vkshardware/frictions/README.md

**vksensor ATV GAZ-71 Friction Clutches controller v2.5**

author: vkshardware (vks100@mail.ru)

GAZ-71 gear Friction Clutches release controllers for 4x4 big tires side-turning ATV like SHERP

2-channel controller for ATV with 1 GP (main gearbox GAZ-71)

4-channel controller for ATV with 2 GP (main gearbox GAZ-71)

Used two electric actuators (Bringsmart 1500N 20mm/s 50mm or Sumotor 1000N 30mm/s 50mm).  

Tourning of ATV is controlled with switches on levers or resistive joystick. 

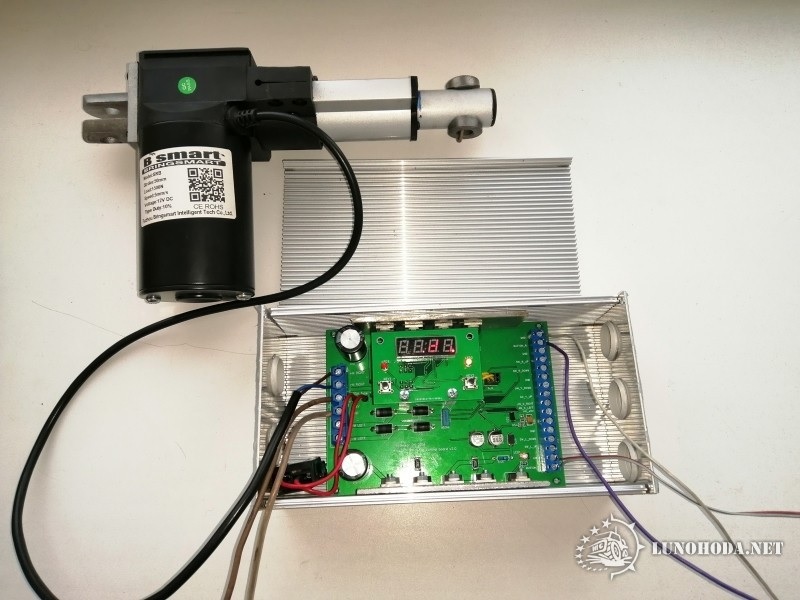
[picture p1: main_view.jpg]


Sources is open and available here

**display** - display board. Atmega8A firmware in Atmel Studio 7

**main_board** - main power board. Atmega324PA firmware in Atmel Strudio 7

****

Electric line actuators mounted like this: 

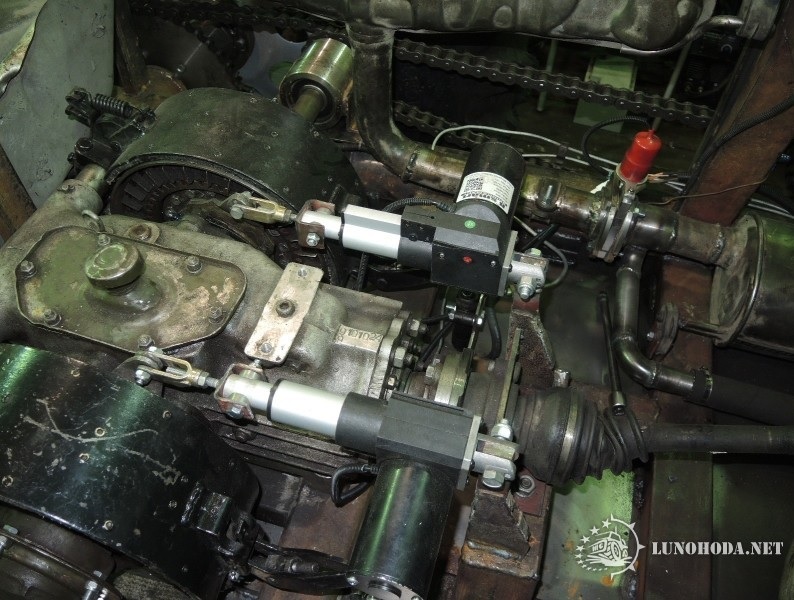
[picture p2: mount_actuators.jpg]


****

Power board module v4.0:

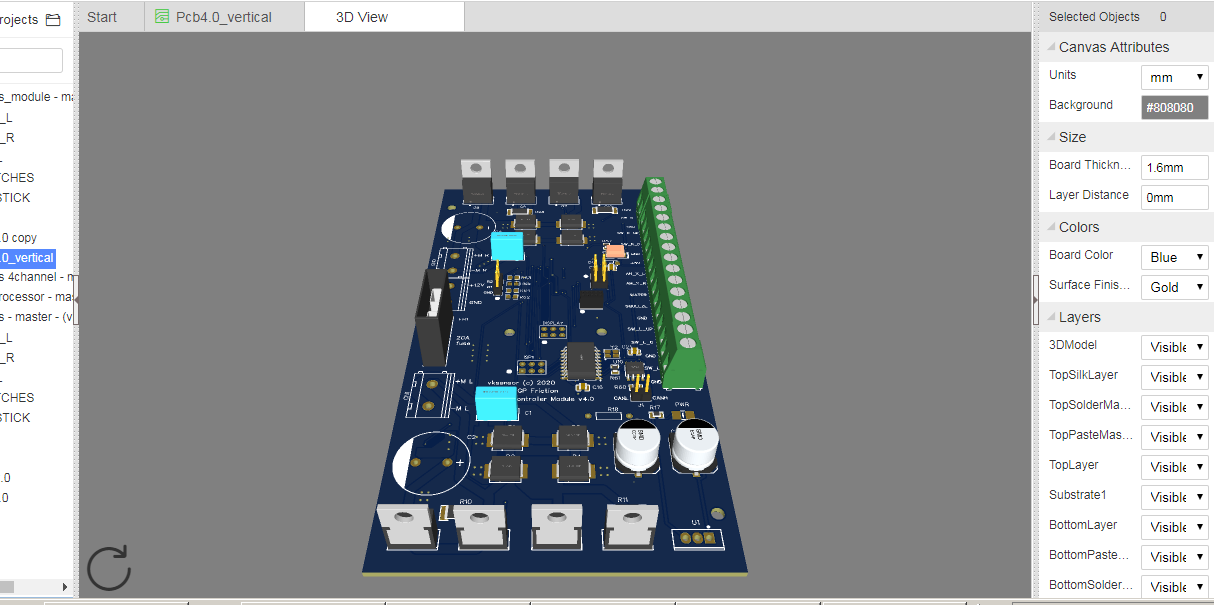
[picture p3: module_v4.0.png]
