vkshardware/frictions/Photos/2-channel controller_pinout_RU.jpg

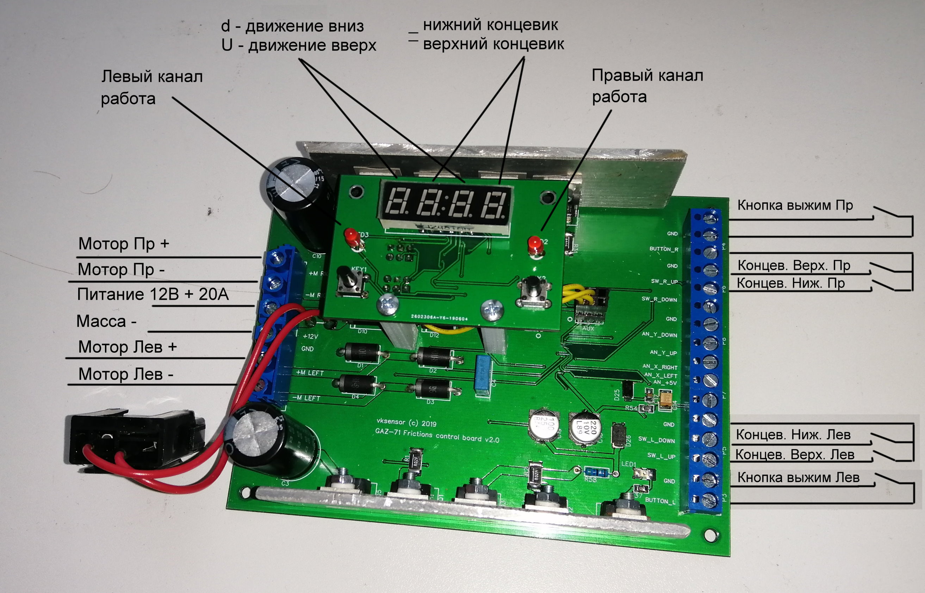
Photos/2-channel controller_pinout_RU.jpg
