vkshardware/frictions/Photos/2-channel controllers 2.jpg

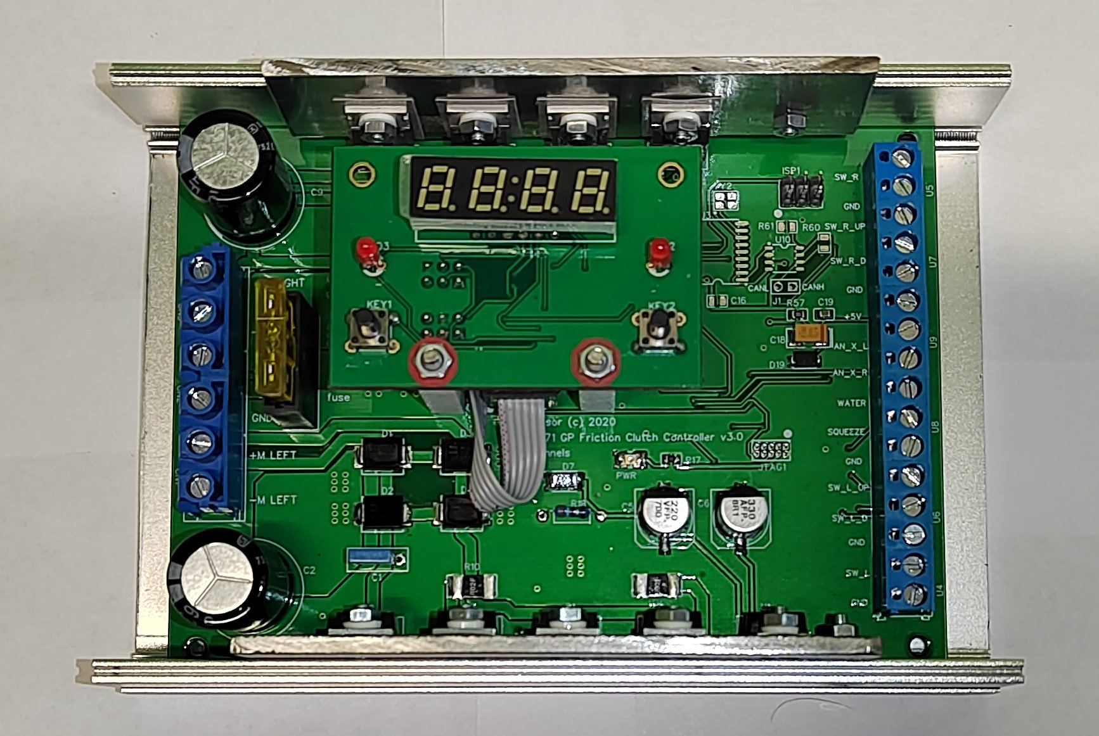
Photos/2-channel controllers 2.jpg
