vkshardware/frictions/Photos/2-channel controllers.jpg

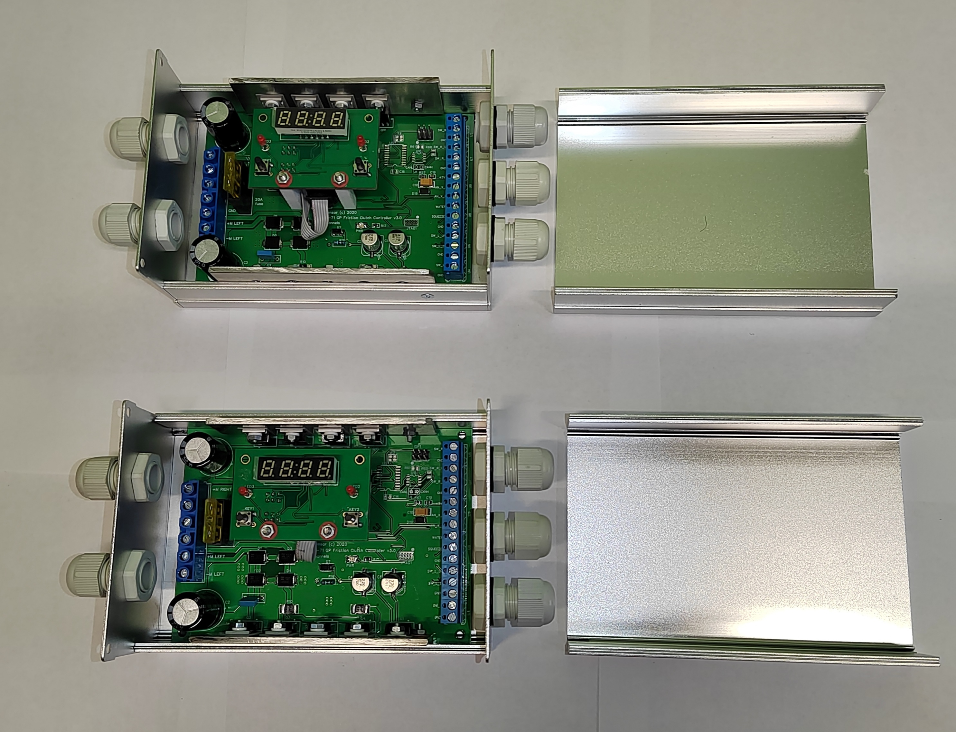
Photos/2-channel controllers.jpg
