vkshardware/frictions/Photos/4-channel controller.jpg

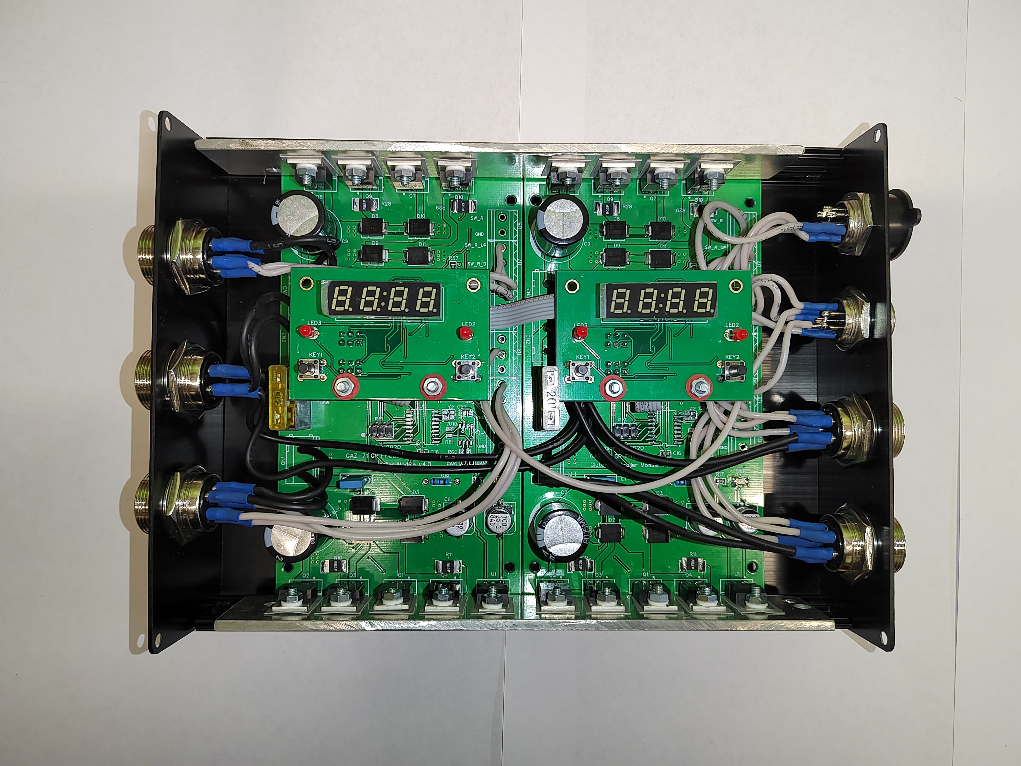
Photos/4-channel controller.jpg
