vkshardware/frictions/Photos/4-channel controller_02.jpg

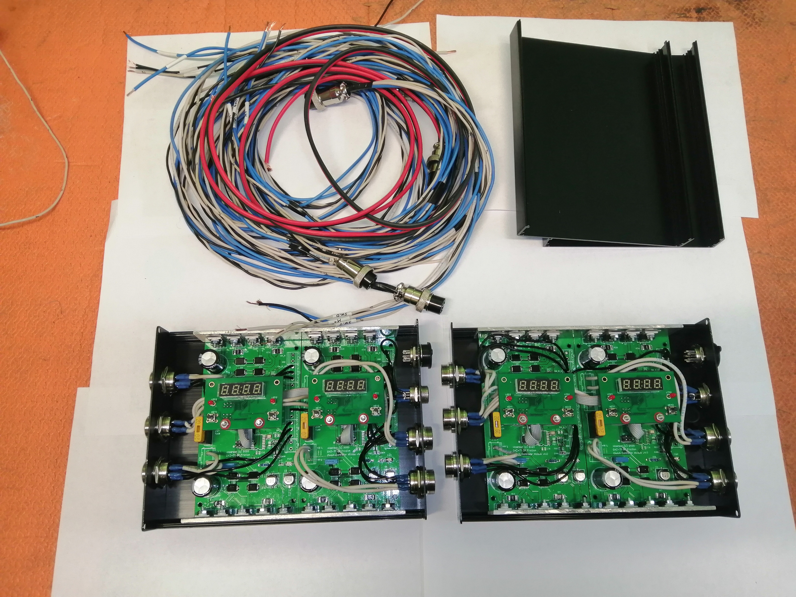
Photos/4-channel controller_02.jpg
