vkshardware/frictions/Photos/4-channel controller_03.jpg

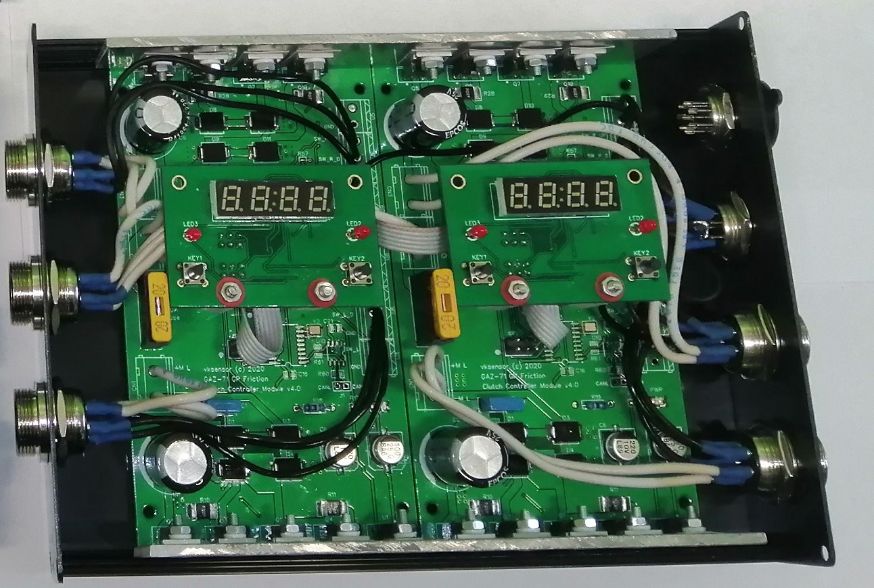
Photos/4-channel controller_03.jpg
