vkshardware/frictions/Photos/4-channel controller_04_RU.png

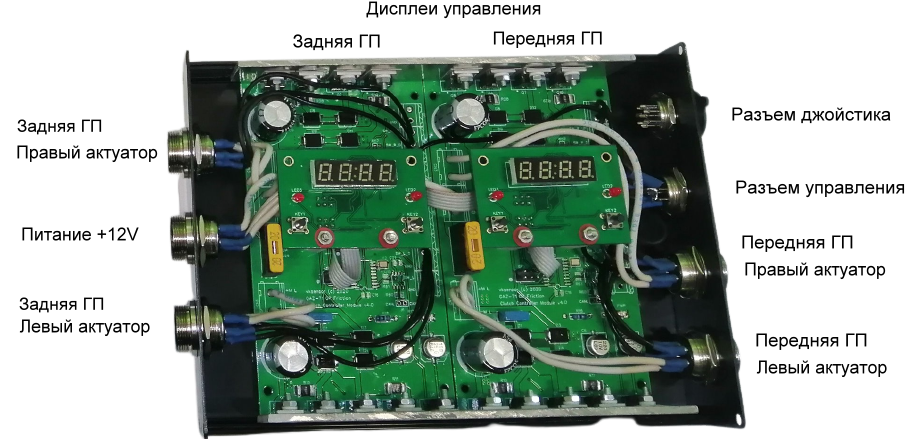
Photos/4-channel controller_04_RU.png
