vkshardware/frictions/Photos/4-channel controller_05.png

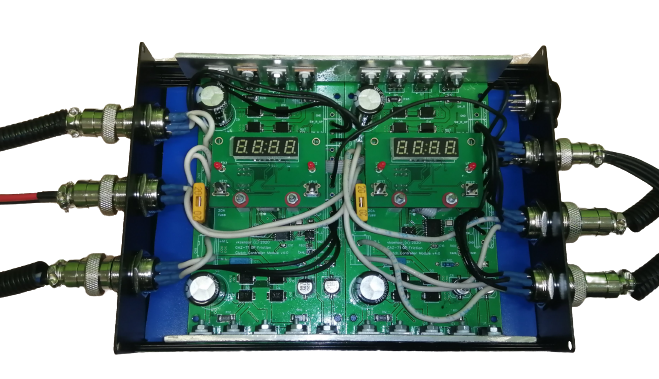
Photos/4-channel controller_05.png
