vkshardware/frictions/Photos/Actuators and Brakes mount/01.JPG

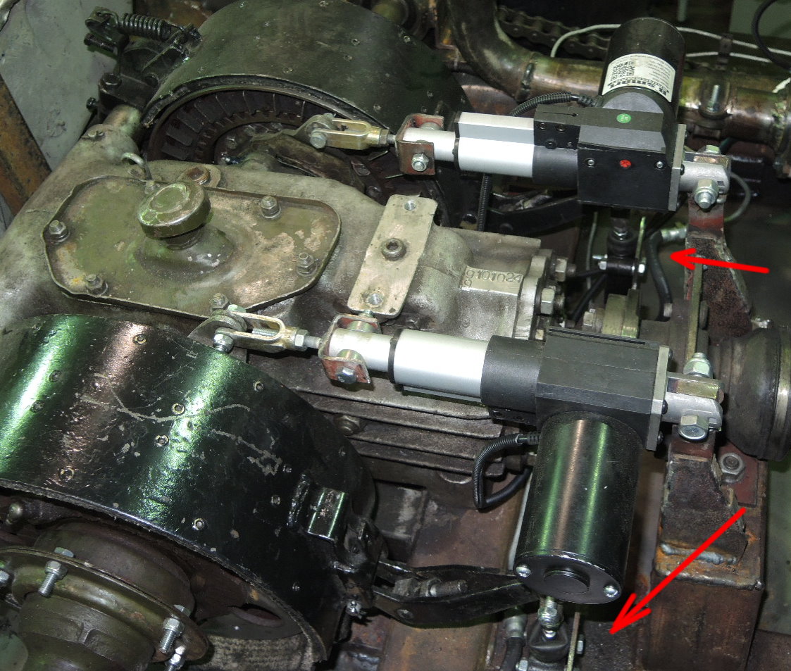
Photos/Actuators and Brakes mount/01.JPG
