vkshardware/frictions/Photos/Actuators and Brakes mount/02.jpg

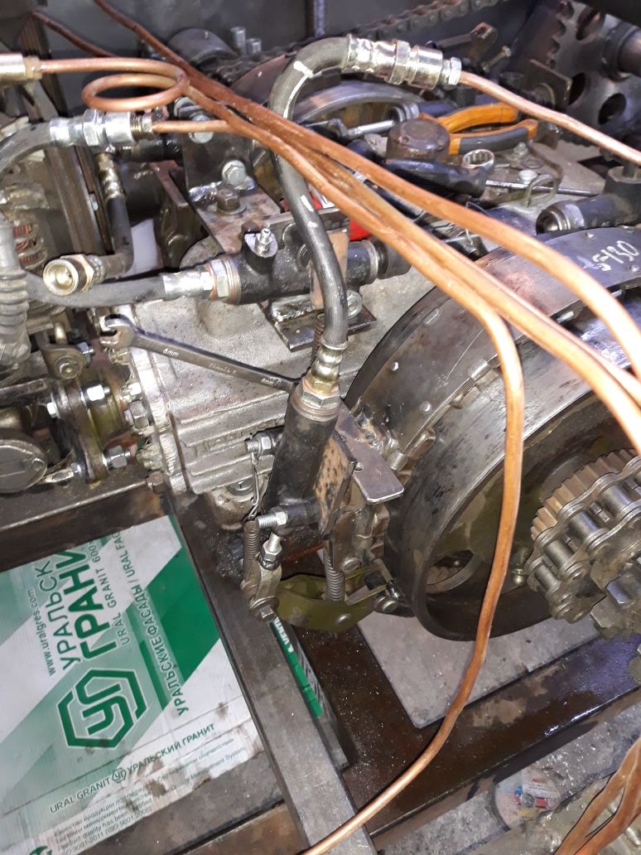
Photos/Actuators and Brakes mount/02.jpg
