vkshardware/frictions/Photos/Actuators and Brakes mount/03.jpg

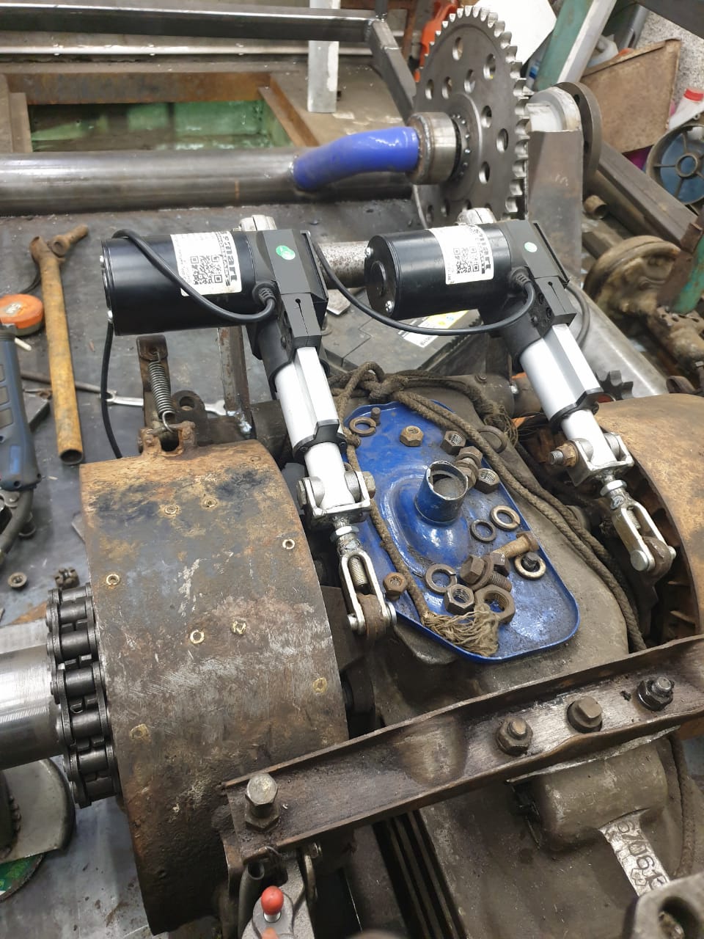
Photos/Actuators and Brakes mount/03.jpg
