vkshardware/frictions/Photos/Actuators and Brakes mount/04.jpg

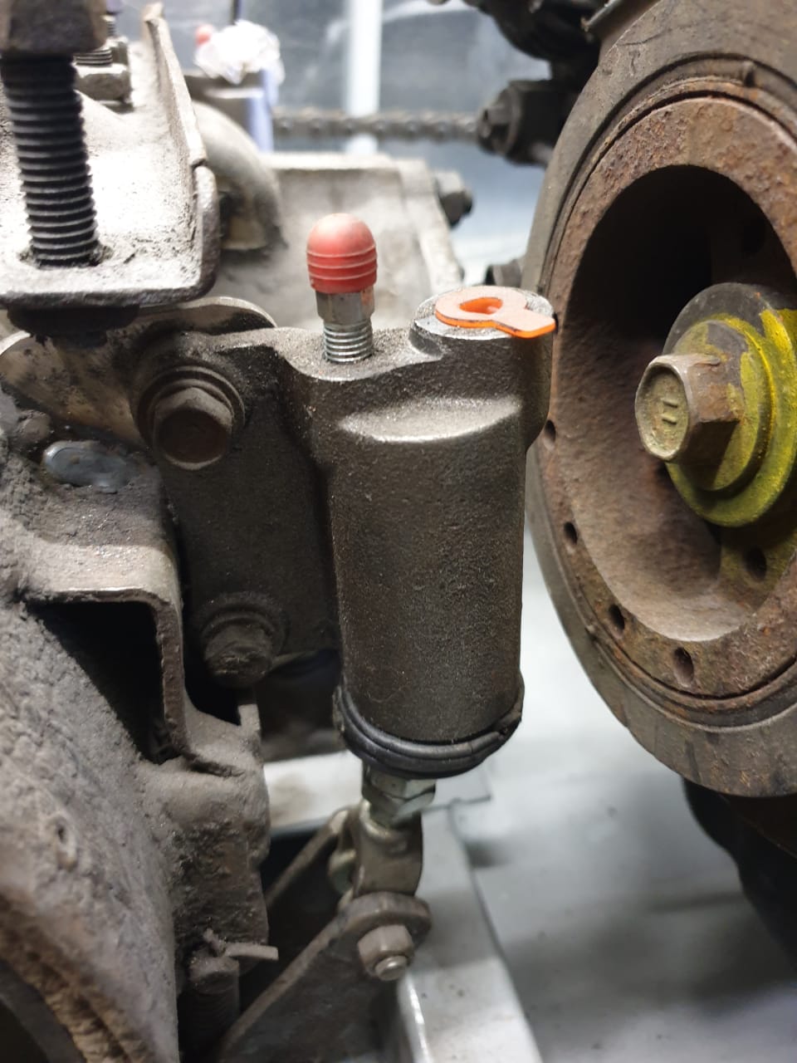
Photos/Actuators and Brakes mount/04.jpg
