vkshardware/frictions/Manuals/actuator _sw1.jpg

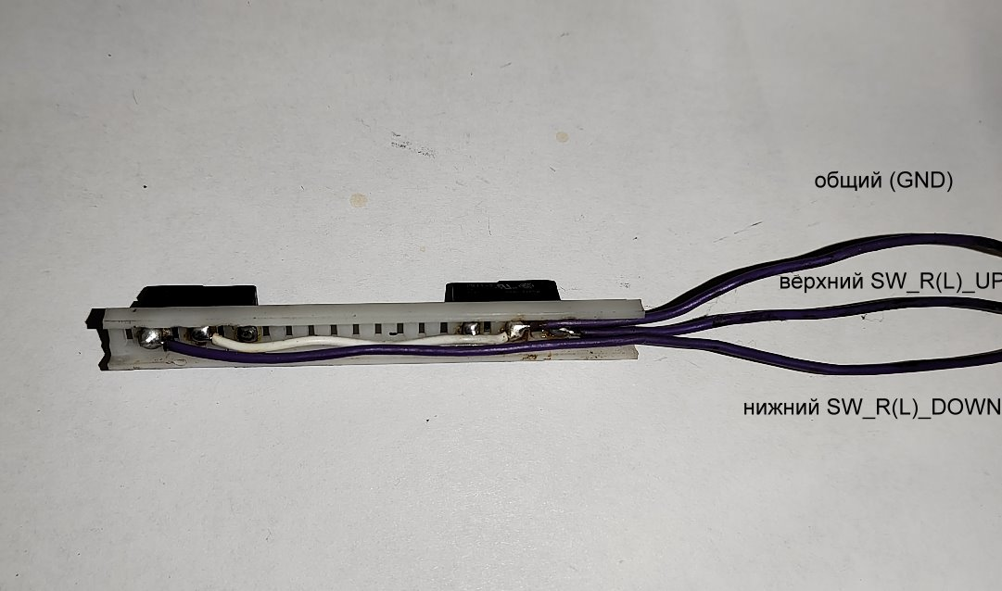
Manuals/actuator _sw1.jpg
