vkshardware/frictions/Manuals/actuator_sw2.jpg

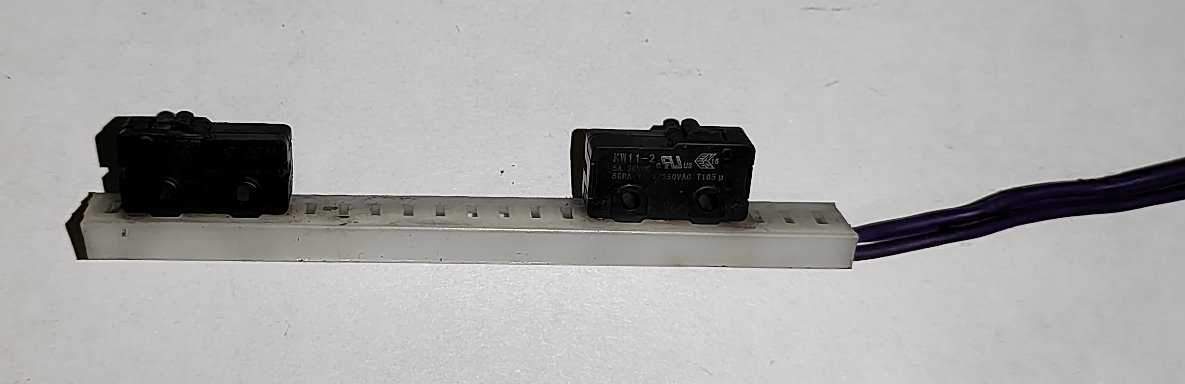
Manuals/actuator_sw2.jpg
