vkshardware/frictions/Photos/2-channell controller installation.jpg

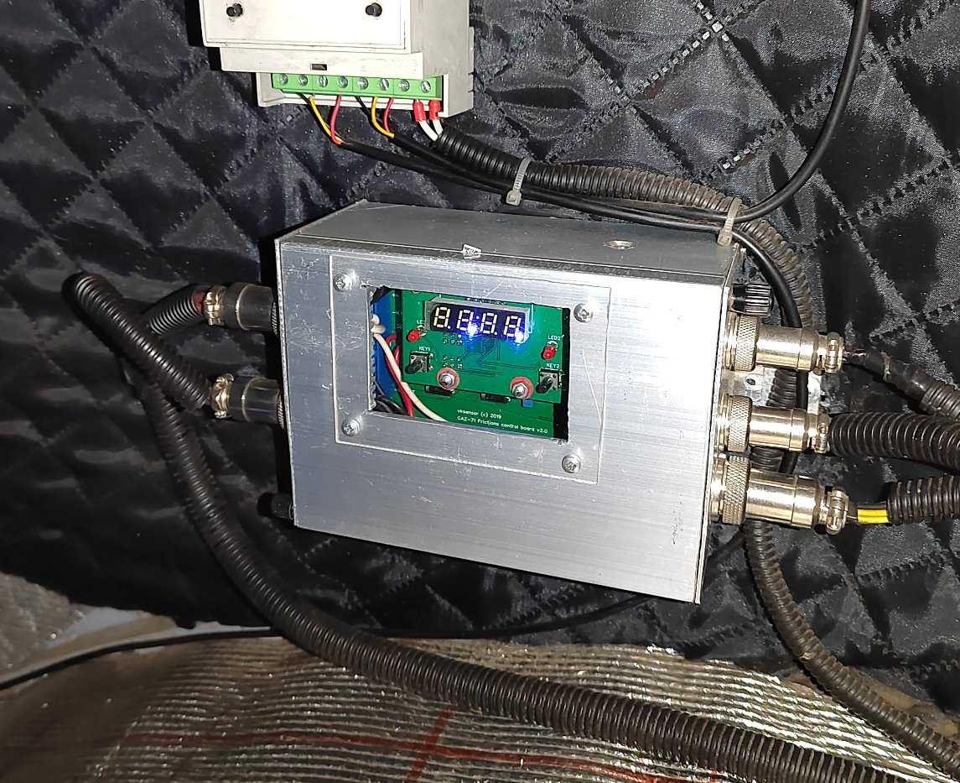
Photos/2-channell controller installation.jpg
