vkshardware/frictions/Schematic/Main_board_atmega324PA/Schematic_friction_module.pdf

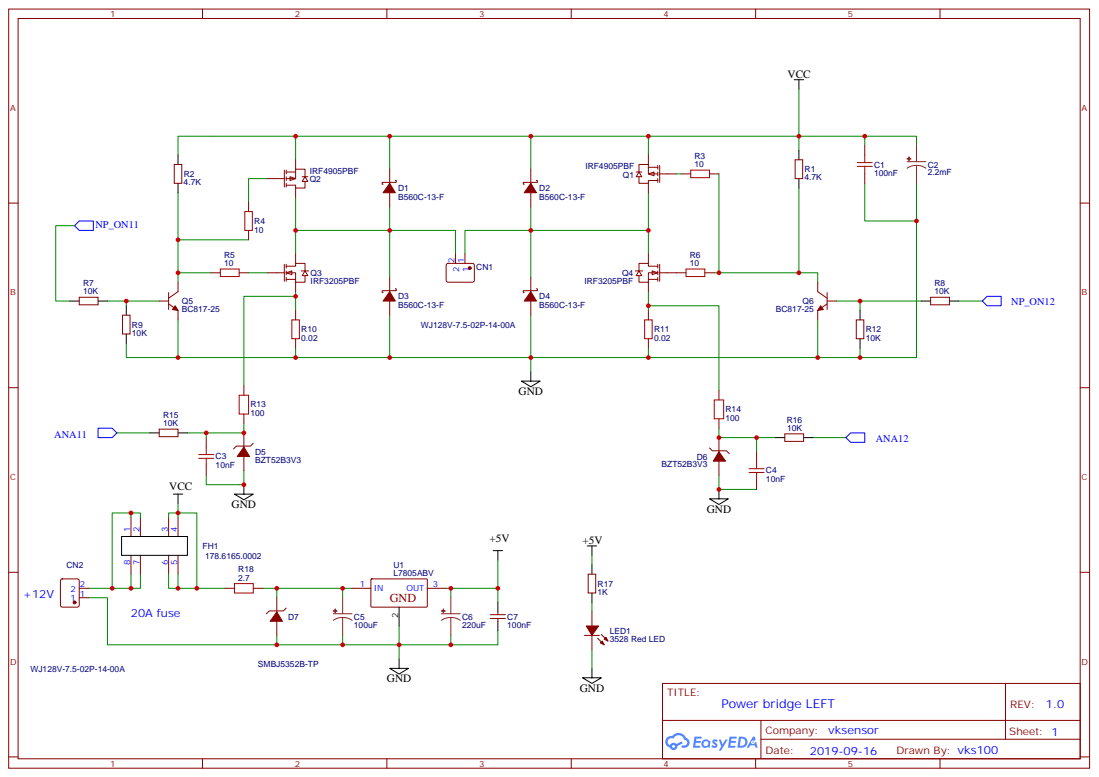
[picture p71: page 1]

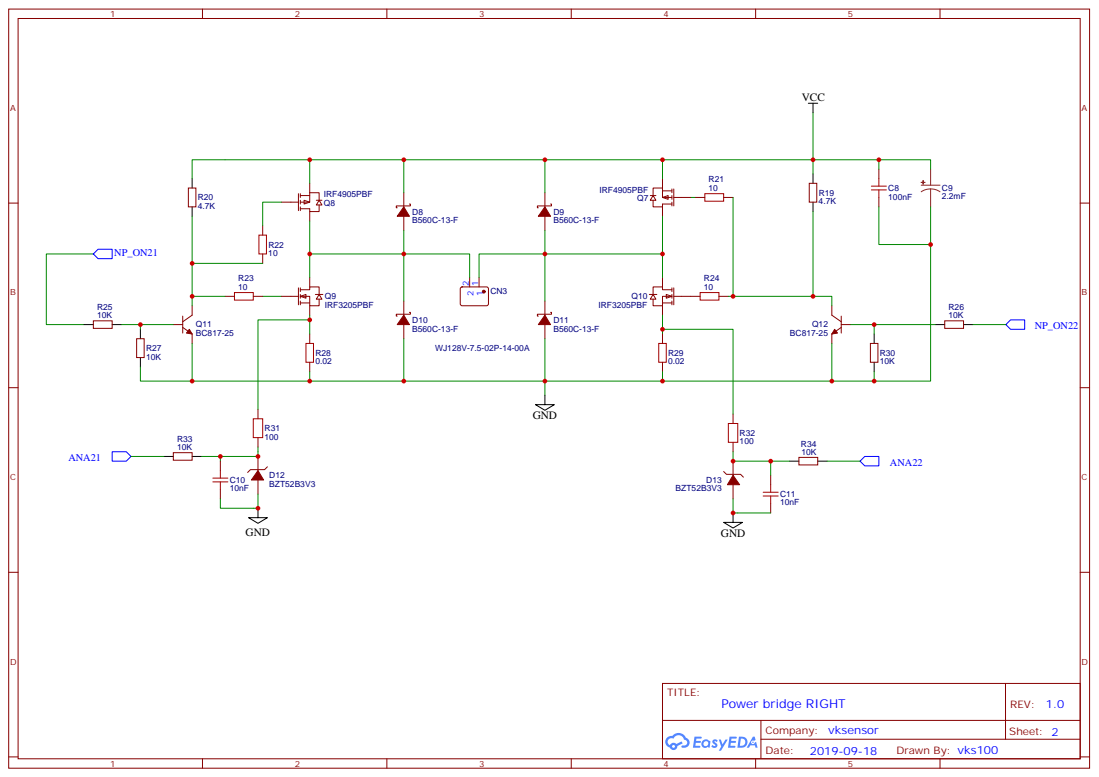
[picture p72: page 2]

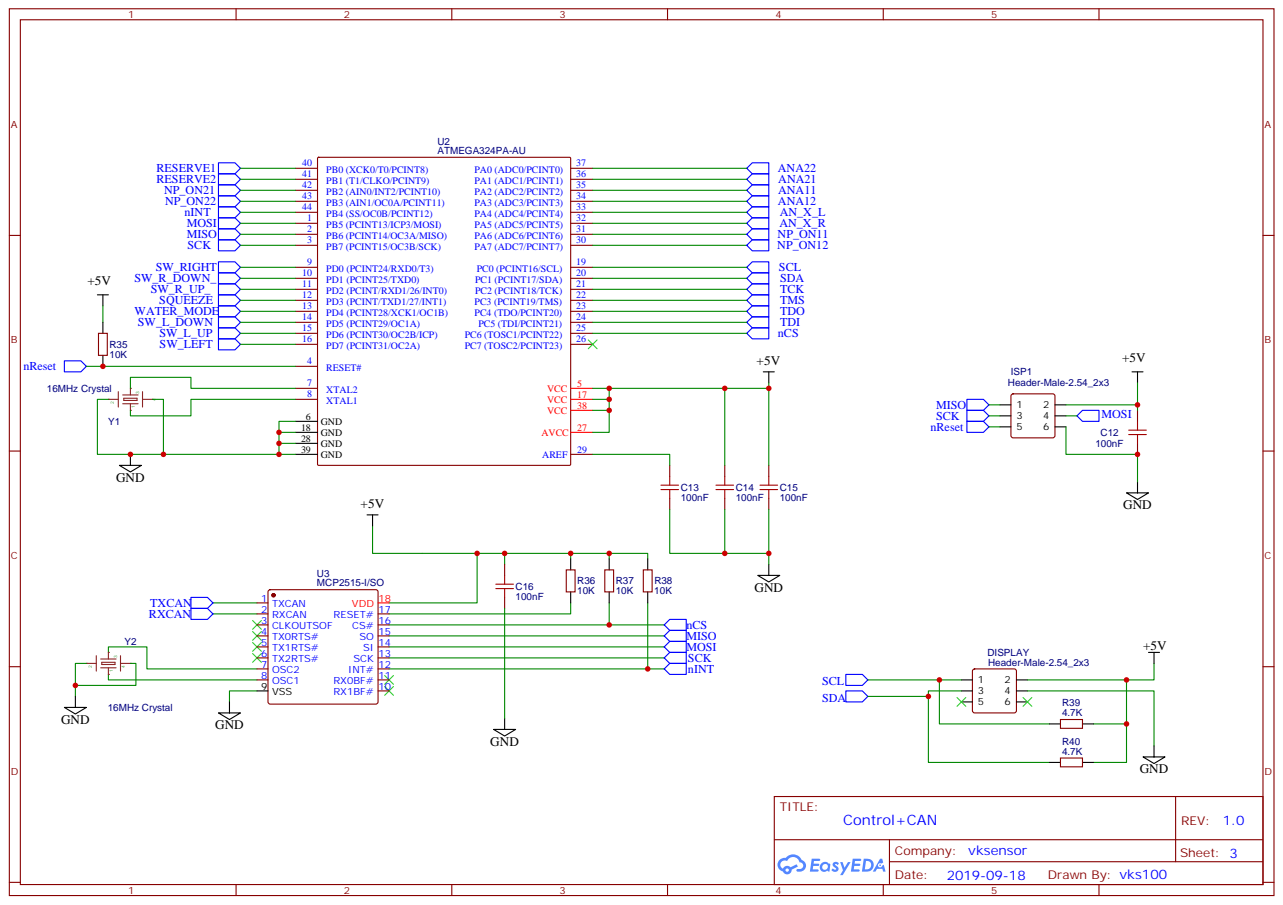
[picture p73: page 3]

MCP2515-I/SO
RX1BF# 10 RX0BF# 11 INT# 12 SCK 13 SI 14 SO 15 CS# 16 RESET# 17 VDD 18

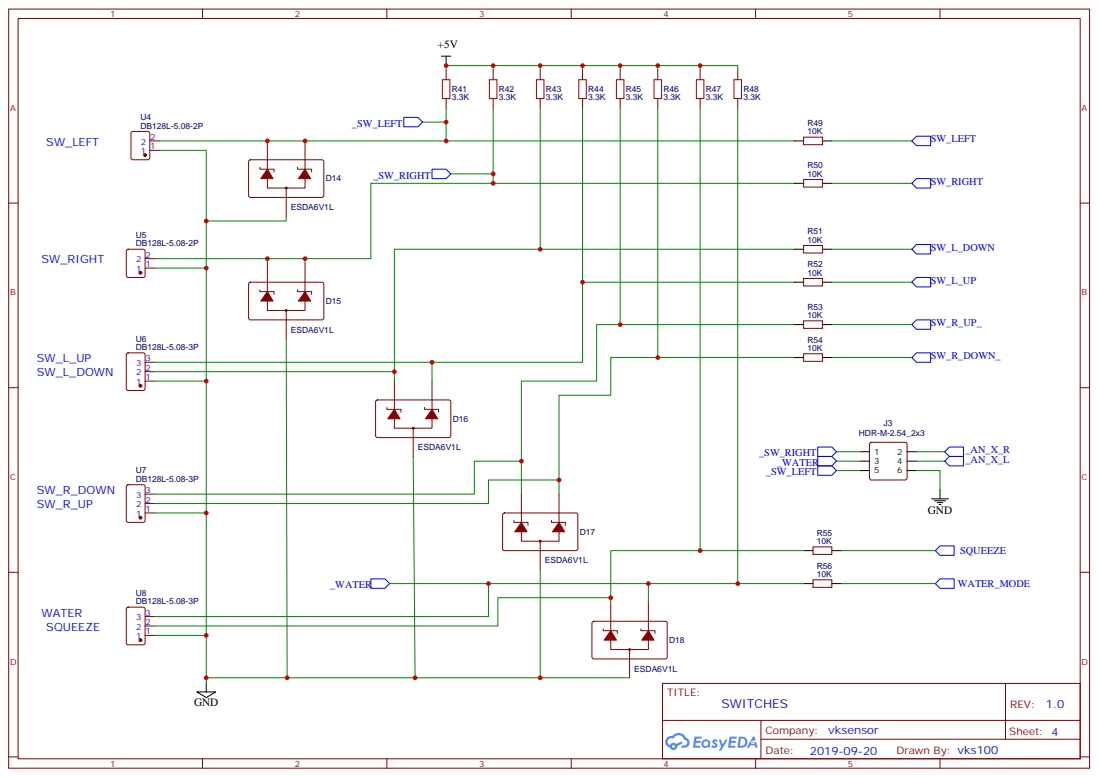
[picture p74: page 4]

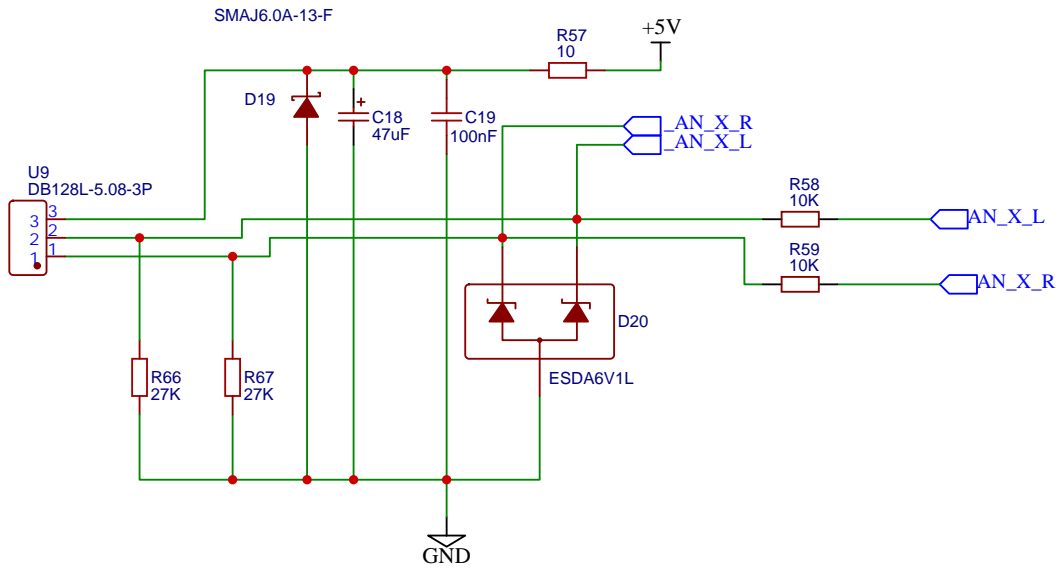
[picture p75: page 5]

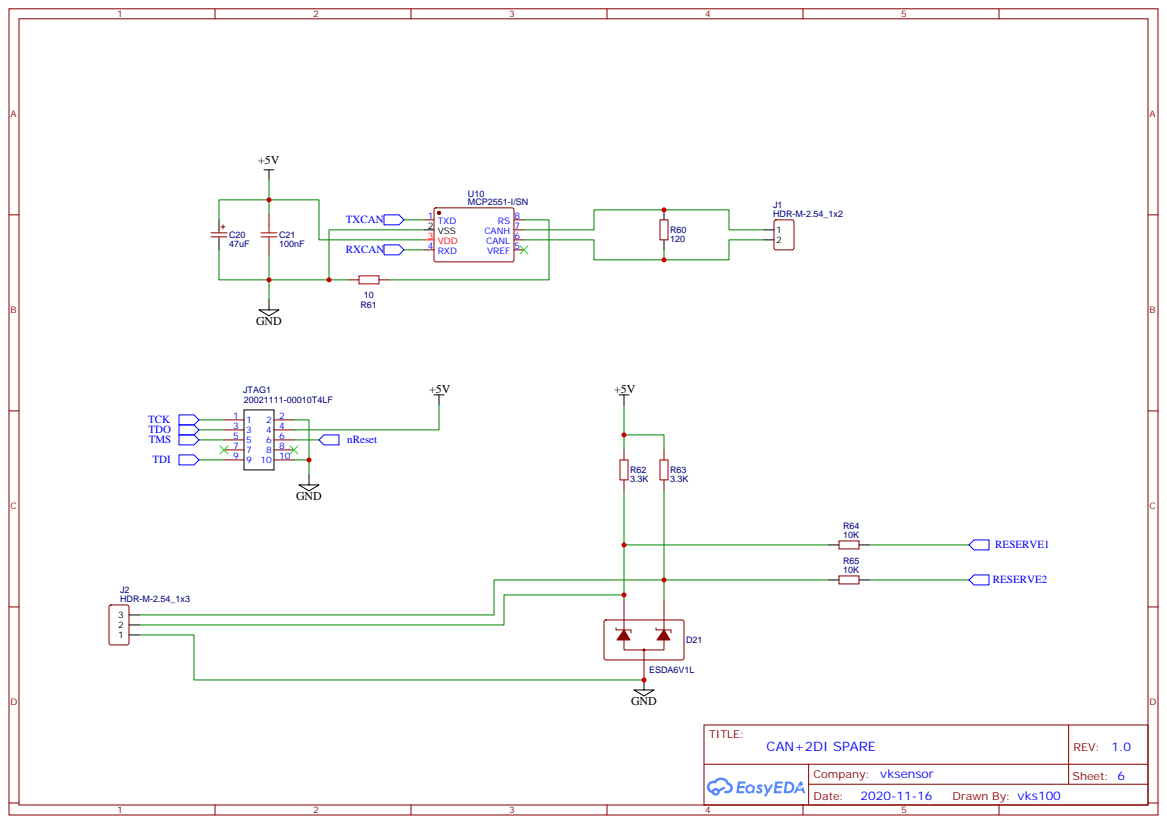
[picture p76: page 6]
