vkshardware/frictions/Schematic/Display_board_atmega324PA/Schematic_disp_seg_i2c.pdf

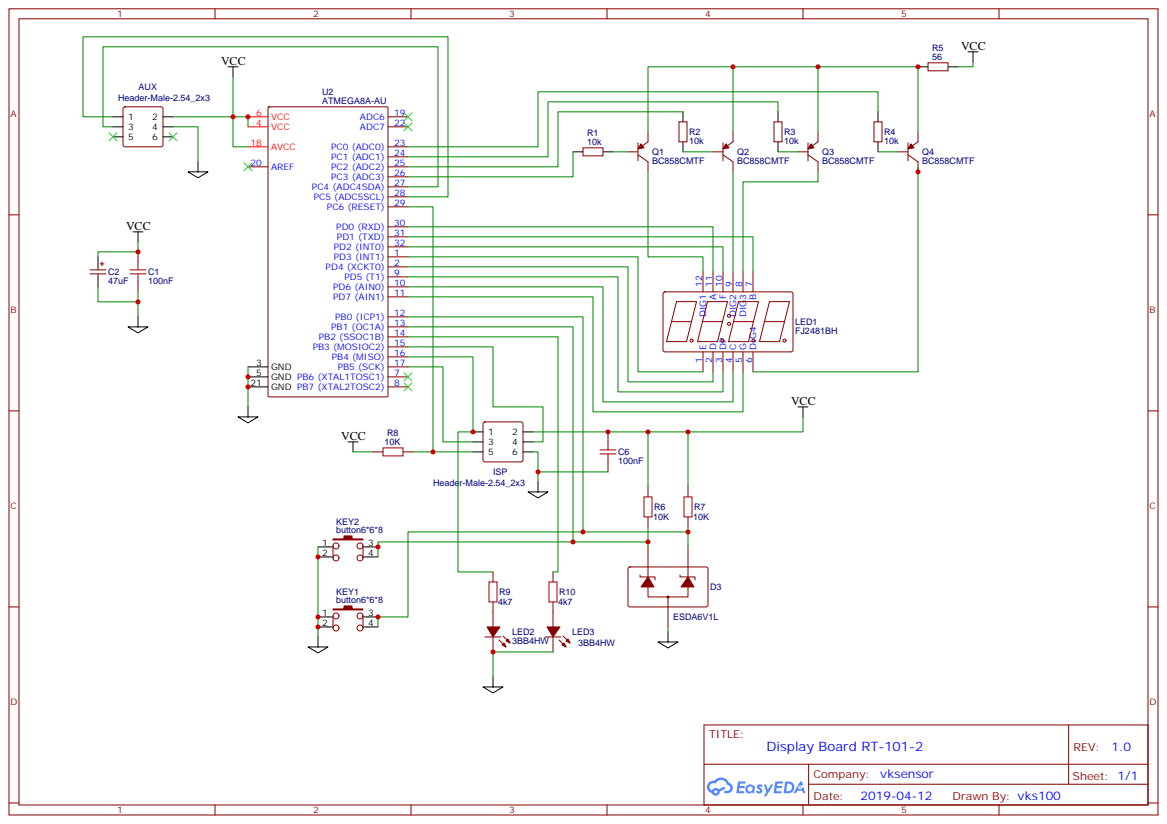
[picture p77: page 1]
