vkshardware/frictions/Schematic/old/Schematic_frictions.pdf

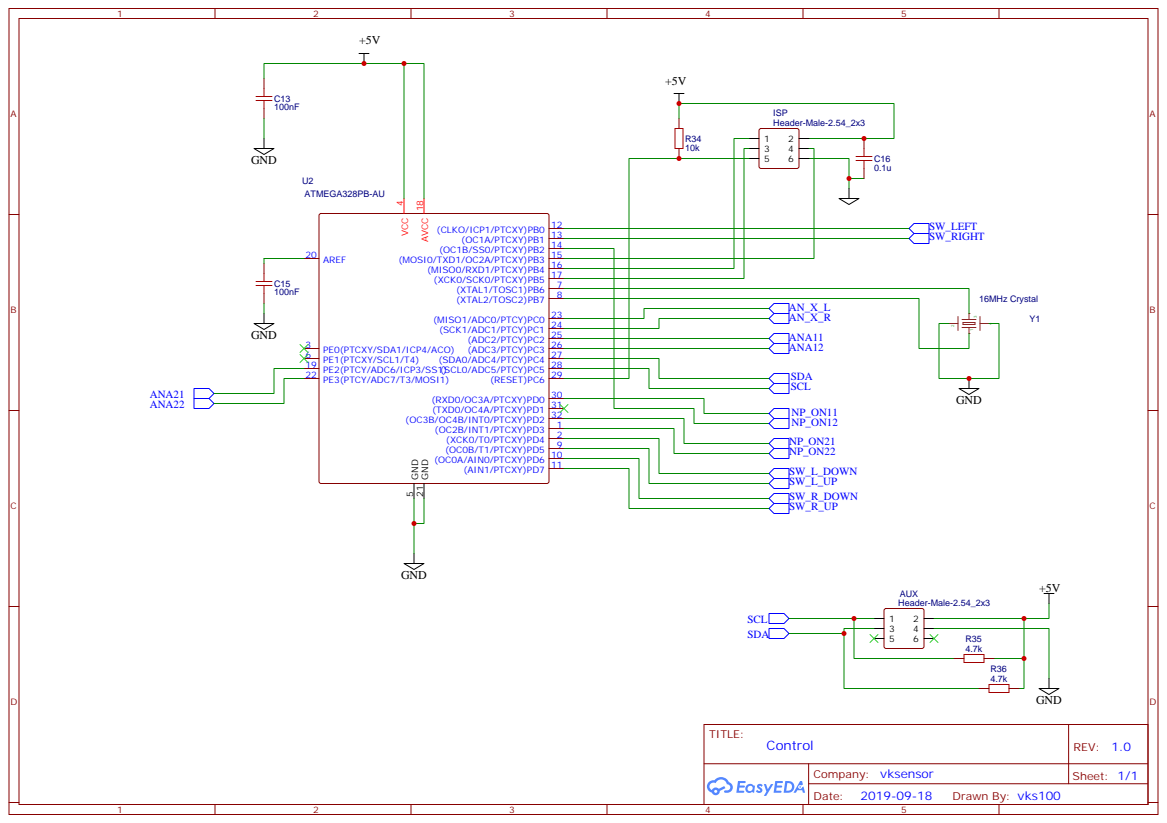
[picture p78: page 1]

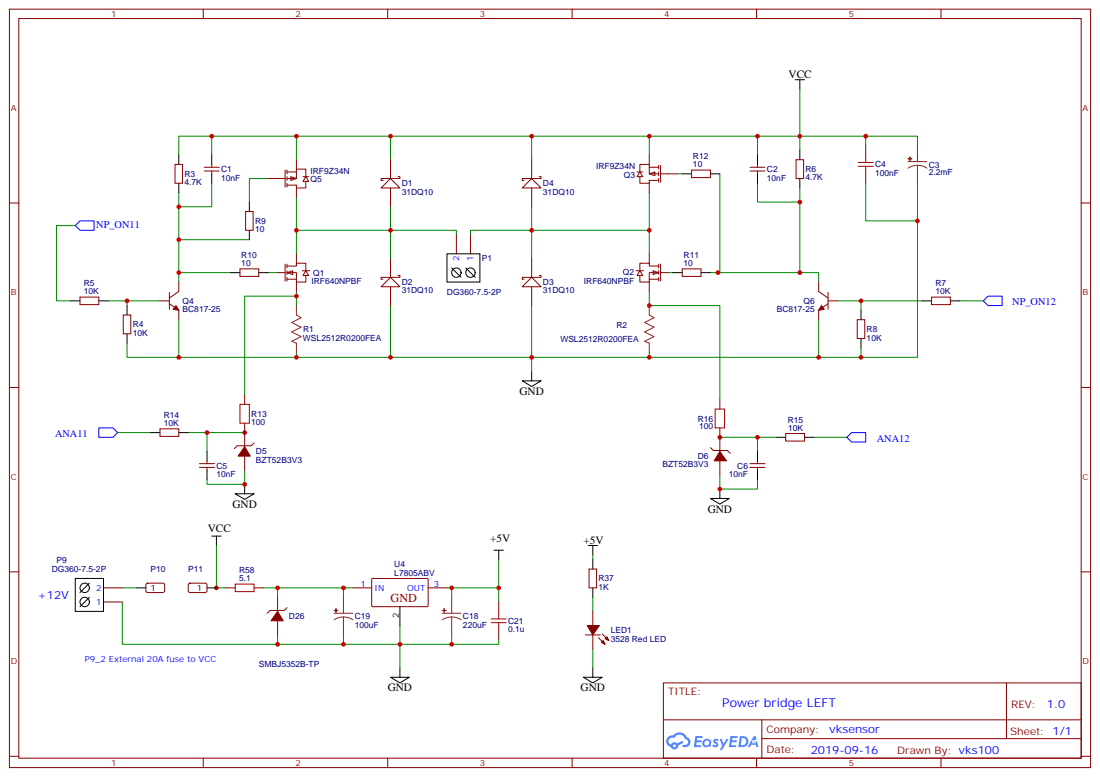
[picture p79: page 2]

P9_2 External 20A fuse to VCC

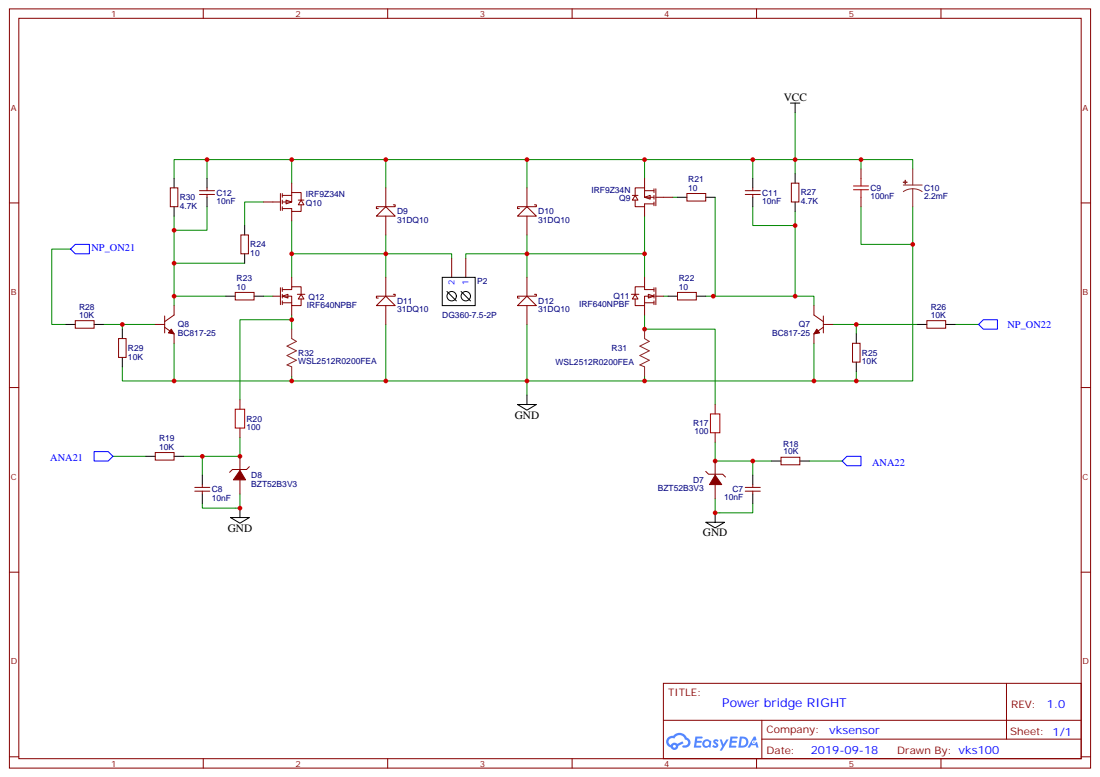
[picture p80: page 3]

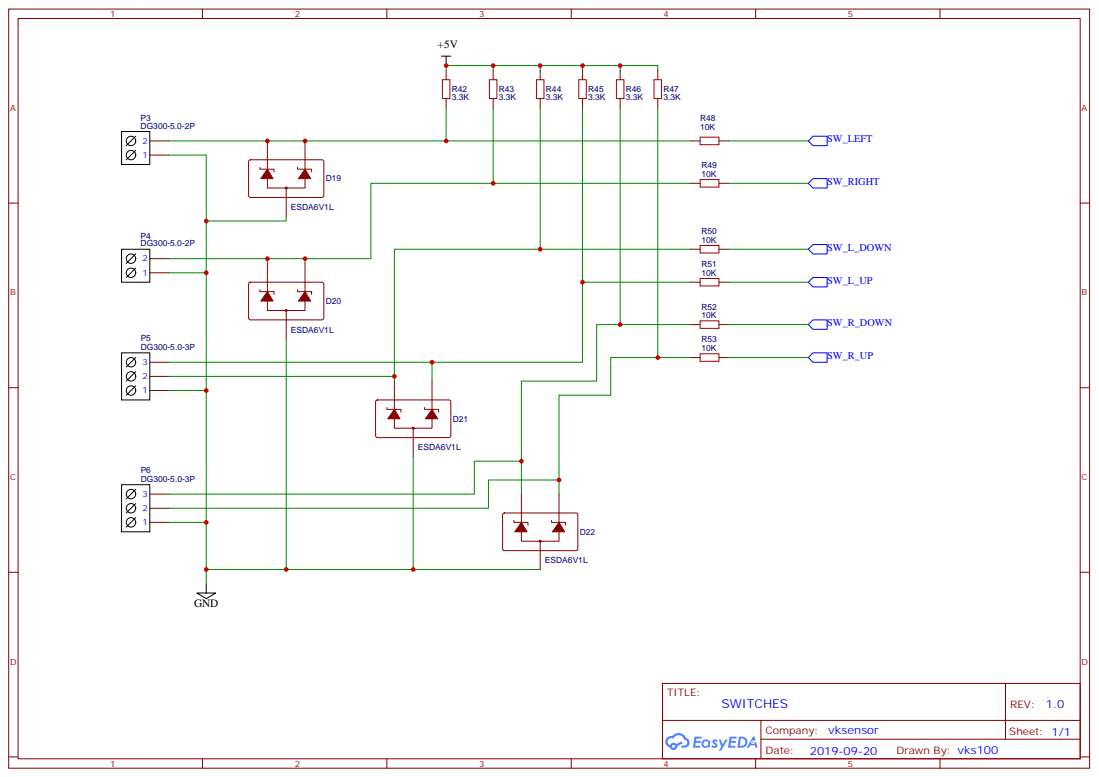
[picture p81: page 4]

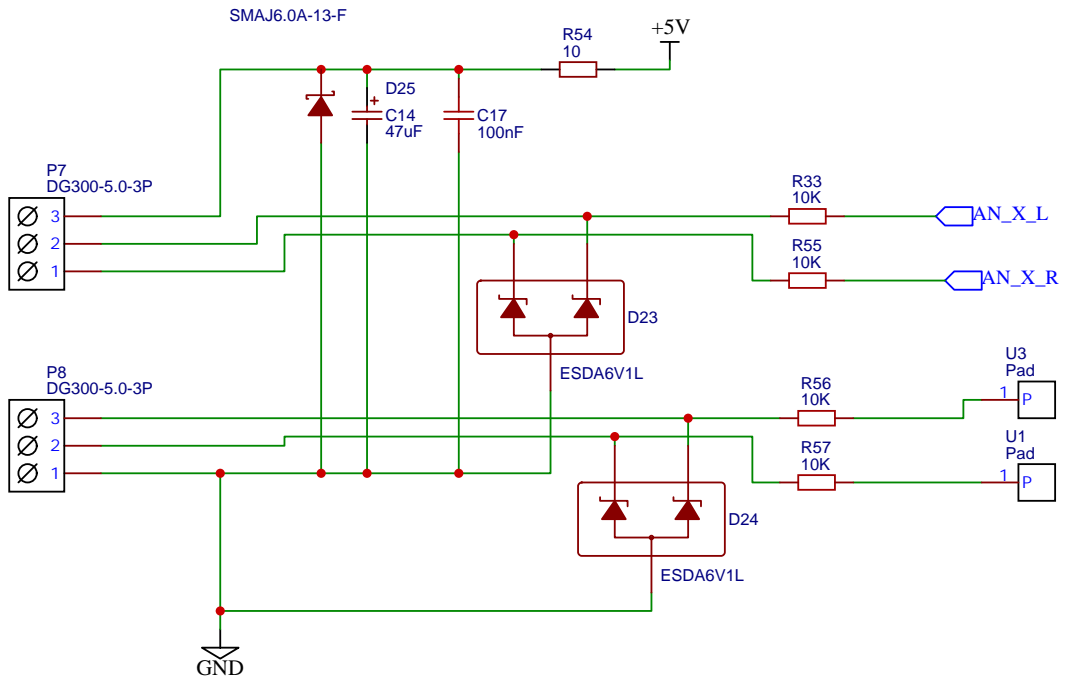
[picture p82: page 5]
