vkshardware/frictions/Firmware/main_board_v2_5/friction_v2.5/spi.cpp

/*************************************************************************

SPI library by Julien Delvaux
*************************************************************************/


#include "spi.h"
/************************************************************************/
/* Constants and macros */
/************************************************************************/
#define SPI_ACTIVE 0 // SS Pin put Low
#define SPI_INACTIVE 1 // SS Pin put High
/* size of RX/TX buffers */
#define SPI_RX_BUFFER_MASK ( SPI_RX_BUFFER_SIZE - 1)
#define SPI_TX_BUFFER_MASK ( SPI_TX_BUFFER_SIZE - 1)
#if ( SPI_RX_BUFFER_SIZE & SPI_RX_BUFFER_MASK )
#error RX buffer size is not a power of 2
#endif
#if ( SPI_TX_BUFFER_SIZE & SPI_TX_BUFFER_MASK )
#error TX buffer size is not a power of 2
#endif
#if defined(__AVR_ATmega48A__) ||defined(__AVR_ATmega48PA__) || defined(__AVR_ATmega88A__) || \
defined(__AVR_ATmega88PA__) ||defined(__AVR_ATmega168A__) || defined(__AVR_ATmega168PA__) || \
defined(__AVR_ATmega328P__)
#define SPI_PIN_SS 2 //SS PIN
#define SPI_PIN_MOSI 3 //MOSI PIN
#define SPI_PIN_MISO 4 //MISO PIN
#define SPI_PIN_SCK 5 //SCK PIN
#define SPI_DDR DDRB //SPI on PORTB
#define SPI_PORT PORTB //SPI on PORTB
#elif defined(__AVR_ATmega164P__) || defined(__AVR_ATmega324PA__) || defined(__AVR_ATmega644P__) || \
defined(__AVR_ATmega1284P__)
#define SPI_PIN_SS 4 //SS PIN
#define SPI_PIN_MOSI 5 //MOSI PIN
#define SPI_PIN_MISO 6 //MISO PIN
#define SPI_PIN_SCK 7 //SCK PIN
#define SPI_DDR DDRB //SPI on PORTB
#define SPI_PORT PORTB //SPI on PORTB
#else
#error "no SPI definition for MCU available"
#endif
/************************************************************************/
/* Global variable */
/************************************************************************/
static volatile uint8_t SPI_TxBuf[SPI_TX_BUFFER_SIZE];
static volatile uint8_t SPI_RxBuf[SPI_RX_BUFFER_SIZE];
static volatile uint8_t SPI_TxHead;
static volatile uint8_t SPI_TxTail;
static volatile uint8_t SPI_RxHead;
static volatile uint8_t SPI_RxTail;
#if defined (SPI_MASTER_ENABLED) && defined(SPI_SLAVE_ENABLED)
#error The multimaster mode of SPI is not yet implement. Do not hesitate to implement it, then submit a pull request ! Thx
#elif defined(SPI_MASTER_ENABLED)
static volatile uint8_t SPI_CTS;
static volatile uint8_t SPI_bytesRequest; // Number of bytes request
#elif defined(SPI_SLAVE_ENABLED)
static volatile uint8_t SPI_SPDR;
#define SPI_SPDR_EMPTY 0
#define SPI_SPDR_FULL 1
#endif

ISR(SPI_STC_vect)
/*************************************************************************
Function: SPI interrupt
Purpose: called when the SS pin has been put low
**************************************************************************/
{
	uint16_t tmphead=0;
	uint16_t tmptail=0;

	/* SPI MASTER */
	#if defined (SPI_MASTER_ENABLED)

	//RECEIVE
	// calculate buffer index
	tmphead = ( SPI_RxHead + 1) & SPI_RX_BUFFER_MASK;
	if ( tmphead == SPI_RxTail ) {
		// error: receive buffer overflow

		} else {
		// store new index
		SPI_RxHead = tmphead;
		// store received data in buffer
		SPI_RxBuf[tmphead] = SPDR0;
	}
	// SEND
	if ( SPI_TxHead != SPI_TxTail) {
		// calculate and store new buffer index
		tmptail = (SPI_TxTail + 1) & SPI_TX_BUFFER_MASK;
		SPI_TxTail = tmptail;
		// get one byte from buffer and write it to UART
		SPDR0 = SPI_TxBuf[tmptail]; // start transmission
	}
	else if(SPI_bytesRequest>0){
		SPI_bytesRequest--;
		SPDR0 = 0x00;
	}
	else {
		// tx buffer empty, STOP the transmission
		SPI_PORT|= (1<<SPI_PIN_SS);
		SPI_CTS = SPI_INACTIVE;
	}
	/* SPI Slave */
	#elif defined(SPI_SLAVE_ENABLED)

	//RECEIVE
	// calculate buffer index
	tmphead = ( SPI_RxHead + 1) & SPI_RX_BUFFER_MASK;
	if ( tmphead == SPI_RxTail ) {
		// error: receive buffer overflow

		} else {
		// store new index
		SPI_RxHead = tmphead;
		// store received data in buffer
		SPI_RxBuf[tmphead] = SPDR;
	}
	// SEND
	if ( SPI_TxHead != SPI_TxTail) {
		// calculate and store new buffer index
		tmptail = (SPI_TxTail + 1) & SPI_TX_BUFFER_MASK;
		SPI_TxTail = tmptail;
		// get one byte from buffer and write it to UART
		SPDR = SPI_TxBuf[tmptail]; //start transmission
	}
	else{
		SPDR=0x00;
	}

	#endif
}
#if defined (SPI_MASTER_ENABLED)
/*************************************************************************
Function: spi_master_init()
Purpose: Initialize SPI in Master Mode
Input: mode SPI_MODEx (x : 0 -> 3)
Input: clock SPI_CLOCK_DIVx (x : 2, 4, 8, 16, 32, 64 or 128)
Returns: none
**************************************************************************/
void spi_master_init(uint8_t mode, uint8_t clock){

	// Pin Configuration
	SPI_DDR = (1<<SPI_PIN_SS) | (1<<SPI_PIN_MOSI) | (1<<SPI_PIN_SCK); // ss, mosi, sck as output, miso as input
	SPI_PORT|= (1<<SPI_PIN_SS);
	//PORTB = 0xff & ~((1<<SPI_PIN_MISO)); // close miso pull up
	// Enable SPI, Master, set clock rate
	SPCR0 = (1<<SPE0)|(1<<MSTR0)|(mode<<CPHA0)|(clock<<SPR00);
}
/*************************************************************************
Function: spi_master_transmit()
Purpose: transmit string to SPI and launch the SPI communication
Input: string to be transmitted
Returns: none
**************************************************************************/
void spi_master_transmit(const char cData){

	/* Start transmission */
	SPDR0 = cData;
	/* Wait for transmission complete */
	// if SPIF == 0
	while(!(SPSR0 & (1<<SPIF0)))
	;

}
/*************************************************************************
Function: spi_master_read()
Purpose: transmit 0x00 to get the number of bytes requested
Input: numberOfBytes that want to be read
Returns: none
**************************************************************************/
char spi_read(void)
{
	SPDR0 = 0x00;
	/* Wait for reception complete */
	while(!(SPSR0 & (1<<SPIF0)))
	;
	/* Return Data Register */
	return SPDR0;
}
/*void spi_master_addSlave(spi_slave_info slave){

}
void spi_master_transmitToSlave(spi_slave_info slave, const char *s){

}*/
#elif defined (SPI_SLAVE_ENABLED)
/*************************************************************************
Function: spi_slave_init()
Purpose: Initialize SPI in Slave Mode
Input: none
Returns: none
**************************************************************************/
void spi_slave_init(void){
	// Set MISO output, all others input
	SPI_DDR |= (1<<SPI_PIN_MISO);
	// set SPI enable, spi interrupts disable
	SPCR = (1<<SPE);
}
/*************************************************************************
Function: spi_slave_receive()
Purpose: read SPI in Slave Mode
Input: none
Returns: none
**************************************************************************/
char spi_slave_receive(void)
{
	SPDR = 0x00;
	/* Wait for reception complete */
	while(!(SPSR & (1<<SPIF)))
	;
	/* Return Data Register */
	return SPDR;
}

#endif
/*************************************************************************
Function: spi_close()
Purpose: Close SPI, flush and clear any received datas
Input: none
Returns: none
**************************************************************************/
void spi_close(void){

	spi_flush();

	SPCR0 = (0x00);
	SPI_DDR &= ~(1<<SPI_PIN_SS);
	SPI_PORT&= ~(1<<SPI_PIN_SS);

}
/*************************************************************************
Function: spi_getc()
Purpose: return byte from ringbuffer
Returns: byte: received byte from ringbuffer
**************************************************************************/
uint8_t spi_getc(void)
{
	uint16_t tmptail;
	uint8_t data;
	if ( SPI_RxHead == SPI_RxTail ) {
		/* no data available */
	}
	/* calculate /store buffer index */
	tmptail = (SPI_RxTail + 1) & SPI_RX_BUFFER_MASK;
	SPI_RxTail = tmptail;
	/* get data from receive buffer */
	data = SPI_RxBuf[tmptail];
	return data;
}
/*************************************************************************
Function: spi_putc()
Purpose: write byte to ringbuffer for transmitting via SPI
Input: byte to be transmitted
Returns: none
**************************************************************************/
void spi_putc(uint8_t data)
{
	uint16_t tmphead;
	tmphead = (SPI_TxHead + 1) & SPI_TX_BUFFER_MASK;

	#if defined (SPI_SLAVE_ENABLED)
	// If no char in SPDR -> fill directly
	if (SPI_TxHead == SPI_TxTail && SPI_SPDR==SPI_SPDR_EMPTY){
		SPDR = data;
		SPI_SPDR = SPI_SPDR_FULL;
	}
	else if (tmphead != SPI_TxTail){
		SPI_TxBuf[tmphead] = data;
		SPI_TxHead = tmphead;
	}
	#elif defined (SPI_MASTER_ENABLED)
	if (tmphead != SPI_TxTail){
		SPI_TxBuf[tmphead] = data;
		SPI_TxHead = tmphead;
	}
	#endif

}
/*************************************************************************
Function: spi_puts()
Purpose: transmit string to SPI
Input: string to be transmitted
Returns: none
**************************************************************************/
void spi_puts(const char *s )
{
	while (*s) {
		spi_putc(*s++);
	}
}
/*************************************************************************
Function: spi_available()
Purpose: Determine the number of bytes waiting in the receive buffer
Input: None
Returns: Integer number of bytes in the receive buffer
**************************************************************************/
uint16_t spi_available(void)
{
	return (SPI_RX_BUFFER_SIZE + SPI_RxHead - SPI_RxTail) & SPI_RX_BUFFER_MASK;
}
/*************************************************************************
Function: spi_flush()
Purpose: Flush bytes waiting the receive buffer. Acutally ignores them.
Input: None
Returns: None
**************************************************************************/
void spi_flush(void)
{
	SPI_RxHead = SPI_RxTail;
}
