vkshardware/frictions/Firmware/main_board_v2_5/friction_v2.5/spi.h

 
/************************************************************************
Title: Interrupt SPI library with receive/transmit circular buffers
Author: Julien Delvaux
Software: Atmel Studio 7
Hardware: AVR 8-Bits, tested with ATmega1284P and ATmega88PA-PU
License: GNU General Public License 3
Usage: see Doxygen manual
 
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
************************************************************************/
/**
* @defgroup avr-spi SPI Library
* @code #include <SPI.h> @endcode
*
* @brief Interrupt SPI library using the built-in SPI with transmit and receive circular buffers.
*
* This library can be used to transmit and receive data through the built in SPI.
*
* @author Julien Delvaux < delvaux.ju@gmail.com>
*/

#ifndef SPI_H_
#define SPI_H_
#include <stdint.h>
#include <avr/io.h>
#include <avr/interrupt.h>
#include <avr/pgmspace.h>

#if (__GNUC__ * 100 + __GNUC_MINOR__) < 304
#error "This library requires AVR-GCC 3.4 or later, update to newer AVR-GCC compiler !"
#endif
/************************************************************************/
/* Constants and macros */
/************************************************************************/
//#define __AVR_ATmega324PA__
/* SPI Mode */
#define SPI_MASTER_ENABLED
//#define SPI_SLAVE_ENABLED
/* Set size of receive and transmit buffers */
#ifndef SPI_RX_BUFFER_SIZE
#define SPI_RX_BUFFER_SIZE 64 /**< Size of the circular receive buffer, must be power of 2 */
#endif
#ifndef SPI_TX_BUFFER_SIZE
#define SPI_TX_BUFFER_SIZE 64 /**< Size of the circular transmit buffer, must be power of 2 */
#endif
/* SPI Mode */
#define SPI_MODE0 0x00
#define SPI_MODE1 0x04
#define SPI_MODE2 0x08
#define SPI_MODE3 0x0C
/* SPI Clock */
#define SPI_CLOCK_DIV4 0x00
#define SPI_CLOCK_DIV16 0x01
#define SPI_CLOCK_DIV64 0x02
#define SPI_CLOCK_DIV128 0x03
#define SPI_CLOCK_DIV2 0x04
#define SPI_CLOCK_DIV8 0x05
#define SPI_CLOCK_DIV32 0x06

/* Slave structure */
struct spi_slave_info
{
uint8_t pin;
uint8_t port;
uint8_t ddr;
};
/************************************************************************/
/* Functions prototype */
/************************************************************************/
/**
@brief Initialize SPI in Master Mode
@param mode SPI_MODEx (x : 0 -> 3)
@param clock SPI_CLOCK_DIVx (x : 2, 4, 8, 16, 32, 64 or 128)
@return none
*/
extern void spi_master_init(uint8_t mode, uint8_t clock);
/**
@brief Initialize SPI in Slave Mode
@param none
@return none
*/
extern void spi_slave_init(void);
/*************************************************************************
Function: spi_slave_receive()
Purpose: read SPI in Slave Mode
Input: none
Returns: none
**************************************************************************/
extern char spi_slave_receive(void);
/**
@brief Close SPI, flush and clear any received datas
@param none
@return none
*/
extern void spi_close(void);
/**
* @brief Put string to ringbuffer for transmitting via SPI & start transmission
* Stop when nothing more to transmit
* @param s string to be transmitted
* @return none
*/
extern void spi_master_transmit(const char cData);
/**
* @brief Read x bytes from the slave
* @param numberOfBytes to read from the slave
* @return none
*/
extern char spi_read(void);
//extern void spi_master_addSlave(spi_slave_info slave);
//extern void spi_master_transmitToSlave(spi_slave_info slave, const char *s);
/**
* @brief Get received byte from ringbuffer
*
* Returns in the lower byte the received character and in the
* higher byte the last receive error.
* SPI_NO_DATA is returned when no data is available.
*
* @return byte: received byte from ringbuffer
*/
extern uint8_t spi_getc(void);
/**
* @brief Put byte to ringbuffer for transmitting via SPI
* @param data byte to be transmitted
* @return none
*/
extern void spi_putc(uint8_t data);
/**
* @brief Put string to ringbuffer for transmitting via SPI
*
* The string is buffered by the SPI library in a circular buffer
* and one character at a time is transmitted to the SPI using interrupts.
* Blocks if it can not write the whole string into the circular buffer.
*
* @param s string to be transmitted
* @return none
*/
extern void spi_puts(const char *s );
/**
* @brief Return number of bytes waiting in the receive buffer
* @return bytes waiting in the receive buffer
*/
extern uint16_t spi_available(void);
/**
* @brief Flush bytes waiting in receive buffer
*/
extern void spi_flush(void);
void extInterruptINIT(void (*handler)(void));
#endif /* SPI_H_ */
