vkshardware/frictions/(notices)

Notices in the files:
Firmware/main_board_v2_5/friction_v2.5/spi.h:
Copyright (C) 2015 Julien Delvaux
